ffmendonca/Projeto-VI/Modelos 3D/modulo_1x1_Kick-Tampa.stl

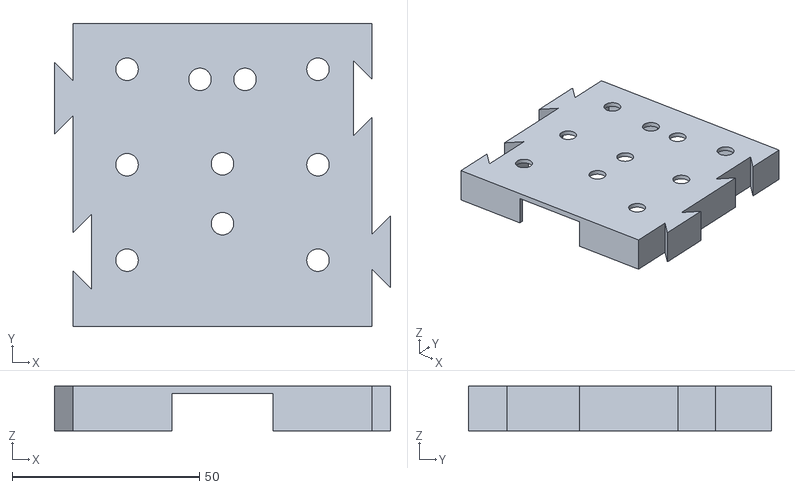
[picture p98: CAD file, 2025-10-30]
Modelos 3D/modulo_1x1_Kick-Tampa.stl
89.8 x 81.0 x 12.0
