ffmendonca/Projeto-VI/Modelos 3D/con_lateral_R.stl

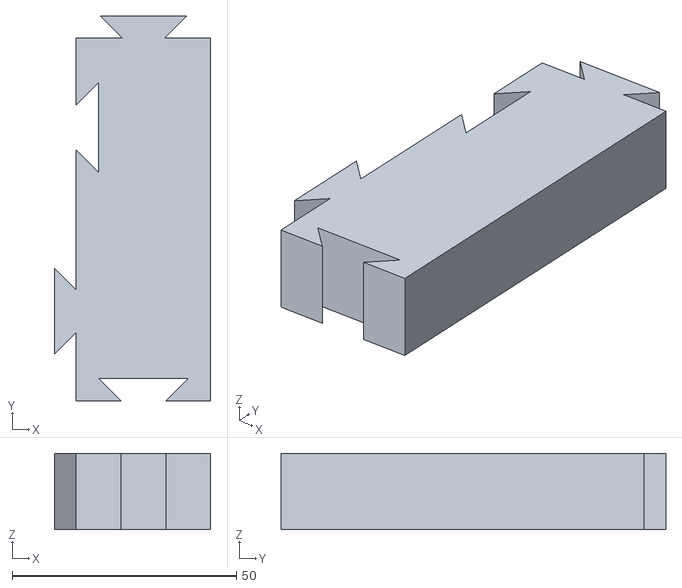
[picture p99: CAD file, 2025-10-30]
Modelos 3D/con_lateral_R.stl
34.9 x 85.9 x 17.0
