ffmendonca/Projeto-VI/Modelos 3D/modulo_1x1-Base.stl

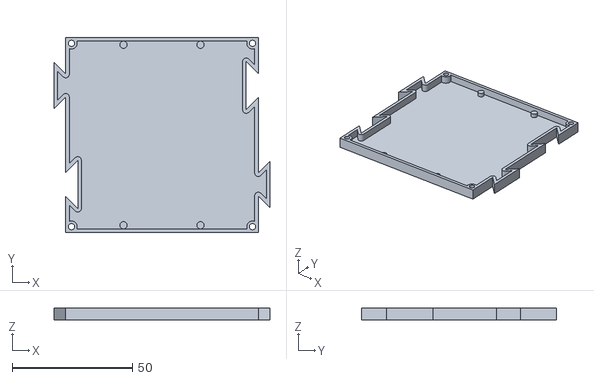
[picture p100: CAD file, 2025-10-30]
Modelos 3D/modulo_1x1-Base.stl
89.8 x 81.0 x 5.00
