ffmendonca/Projeto-VI/(list of files, cad)

Other CAD files:
Modelos 3D/modulo_1x1-Tampa.stl
Modelos 3D/con_lateral_L.stl
