ffmendonca/Projeto-VI/Esquemáticas/BOMBO.pdf

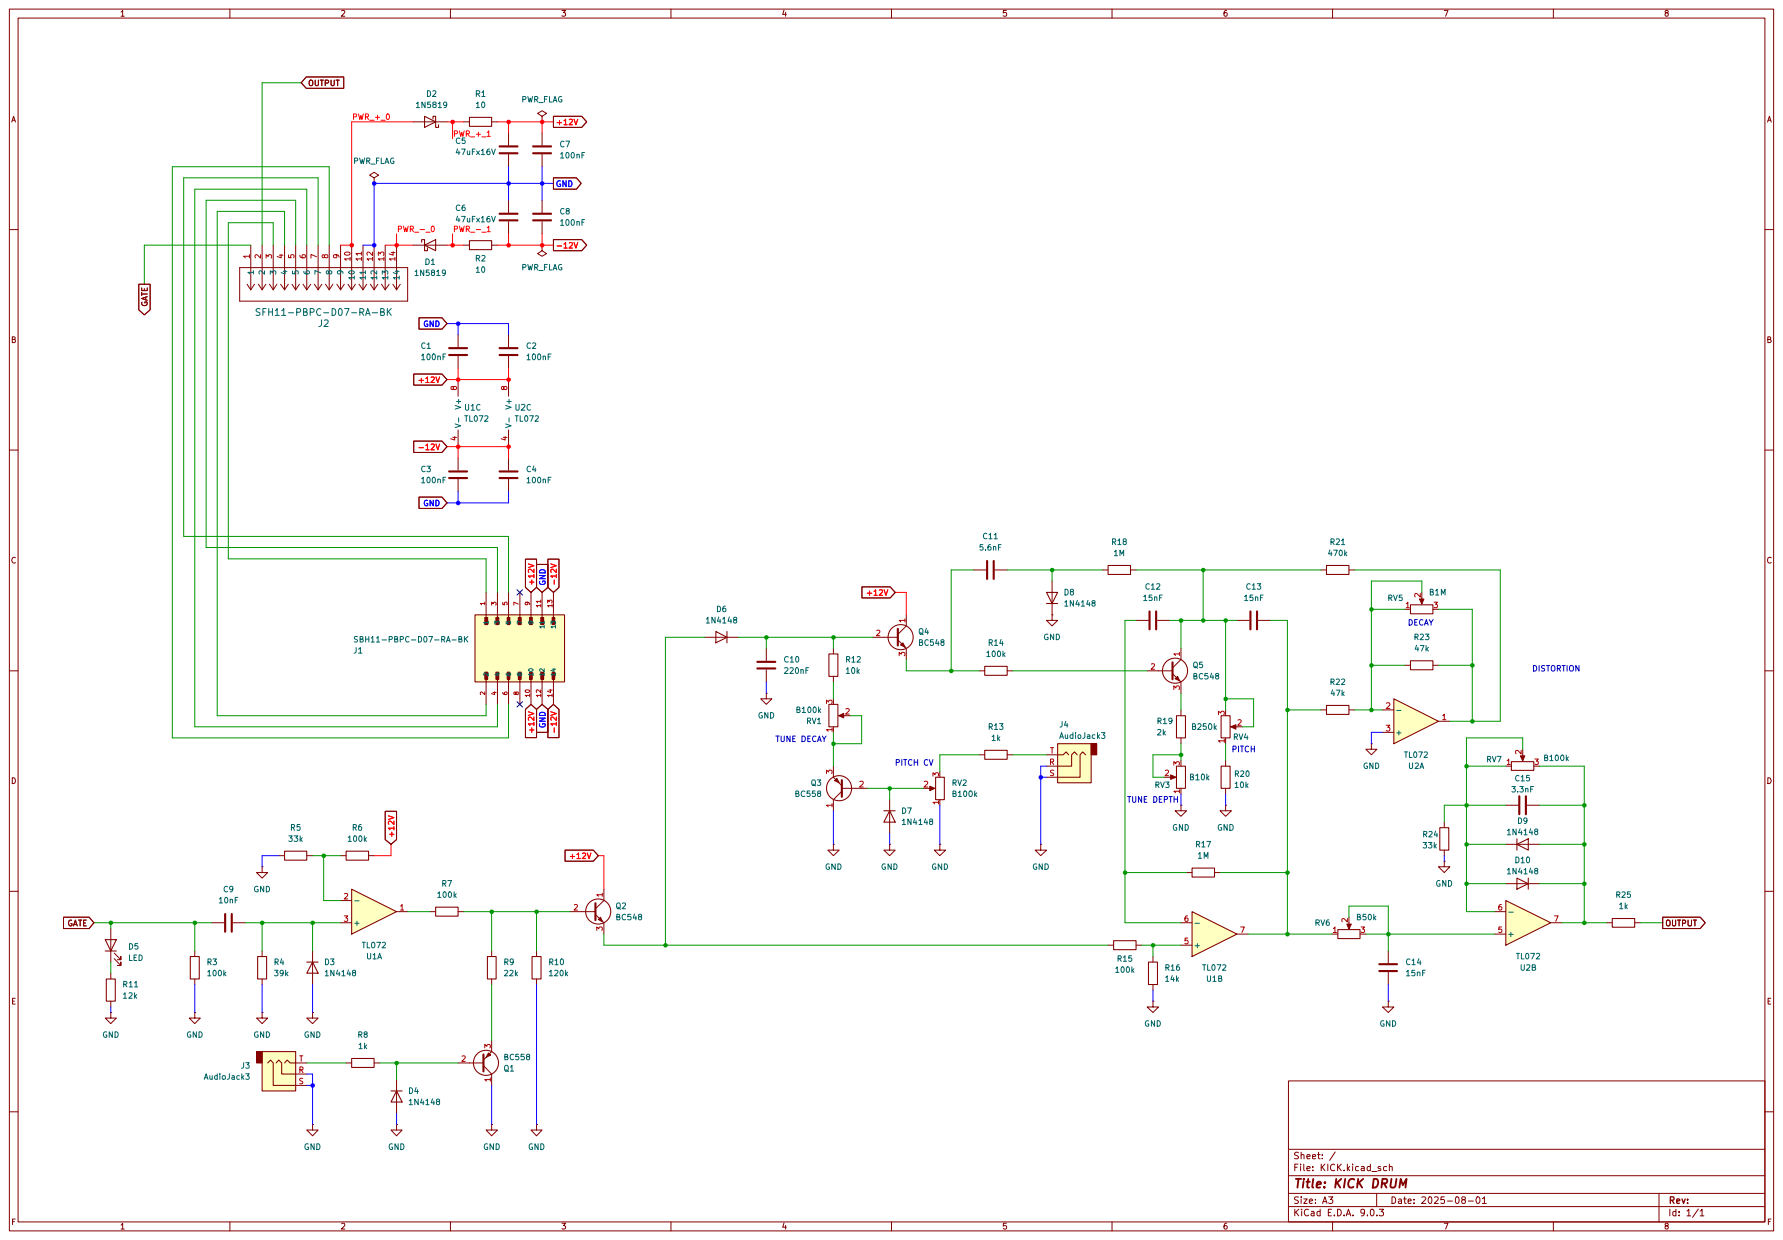
[picture p101: page 1]
