ffmendonca/Projeto-VI/Esquemáticas/INPUT ALIMENTAÇÃO.pdf

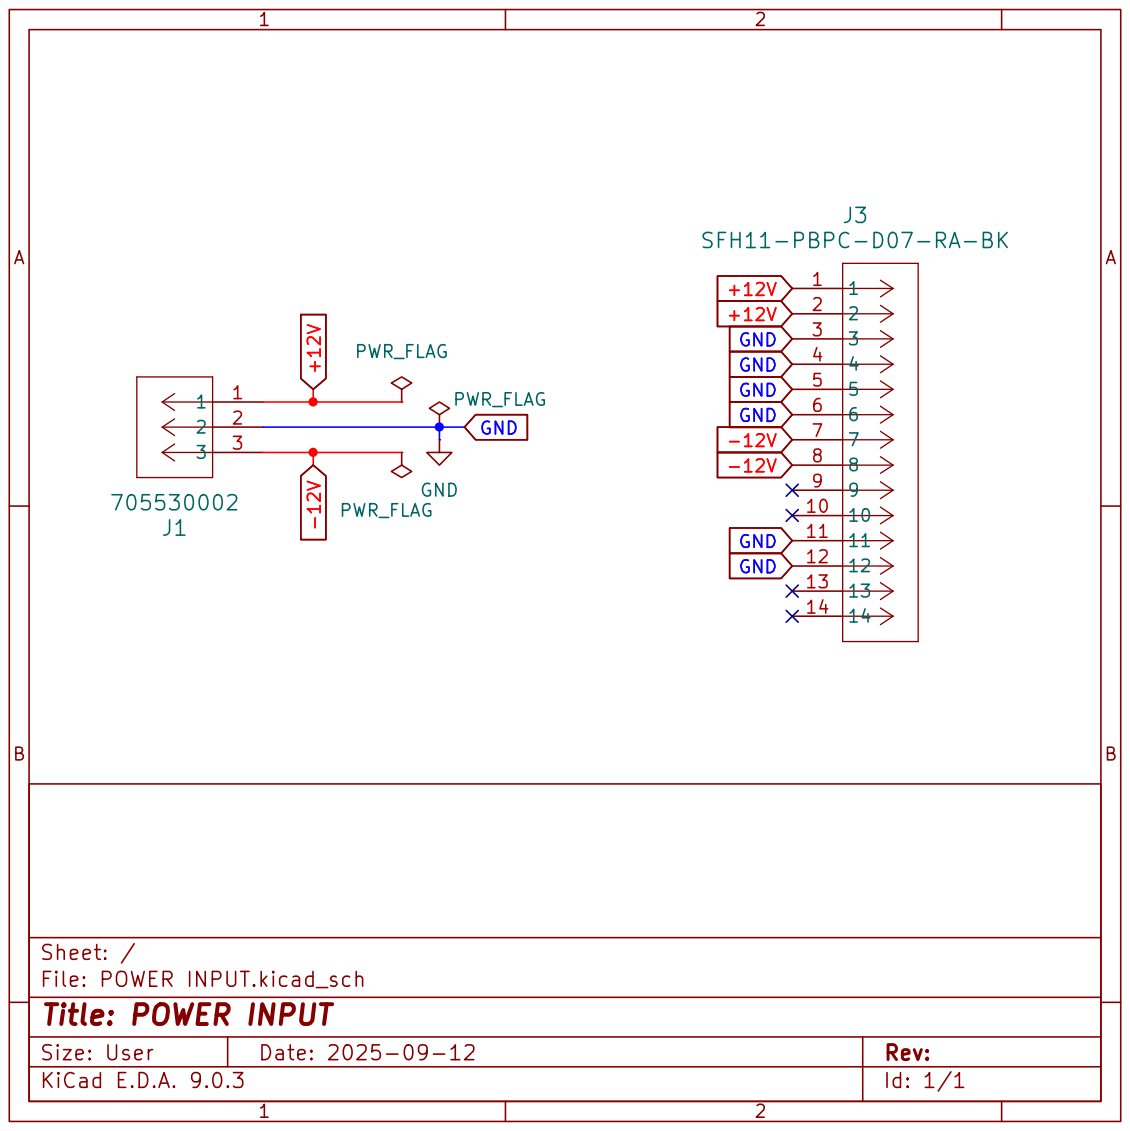
[picture p102: page 1]
