ffmendonca/Projeto-VI/Esquemáticas/IO.pdf

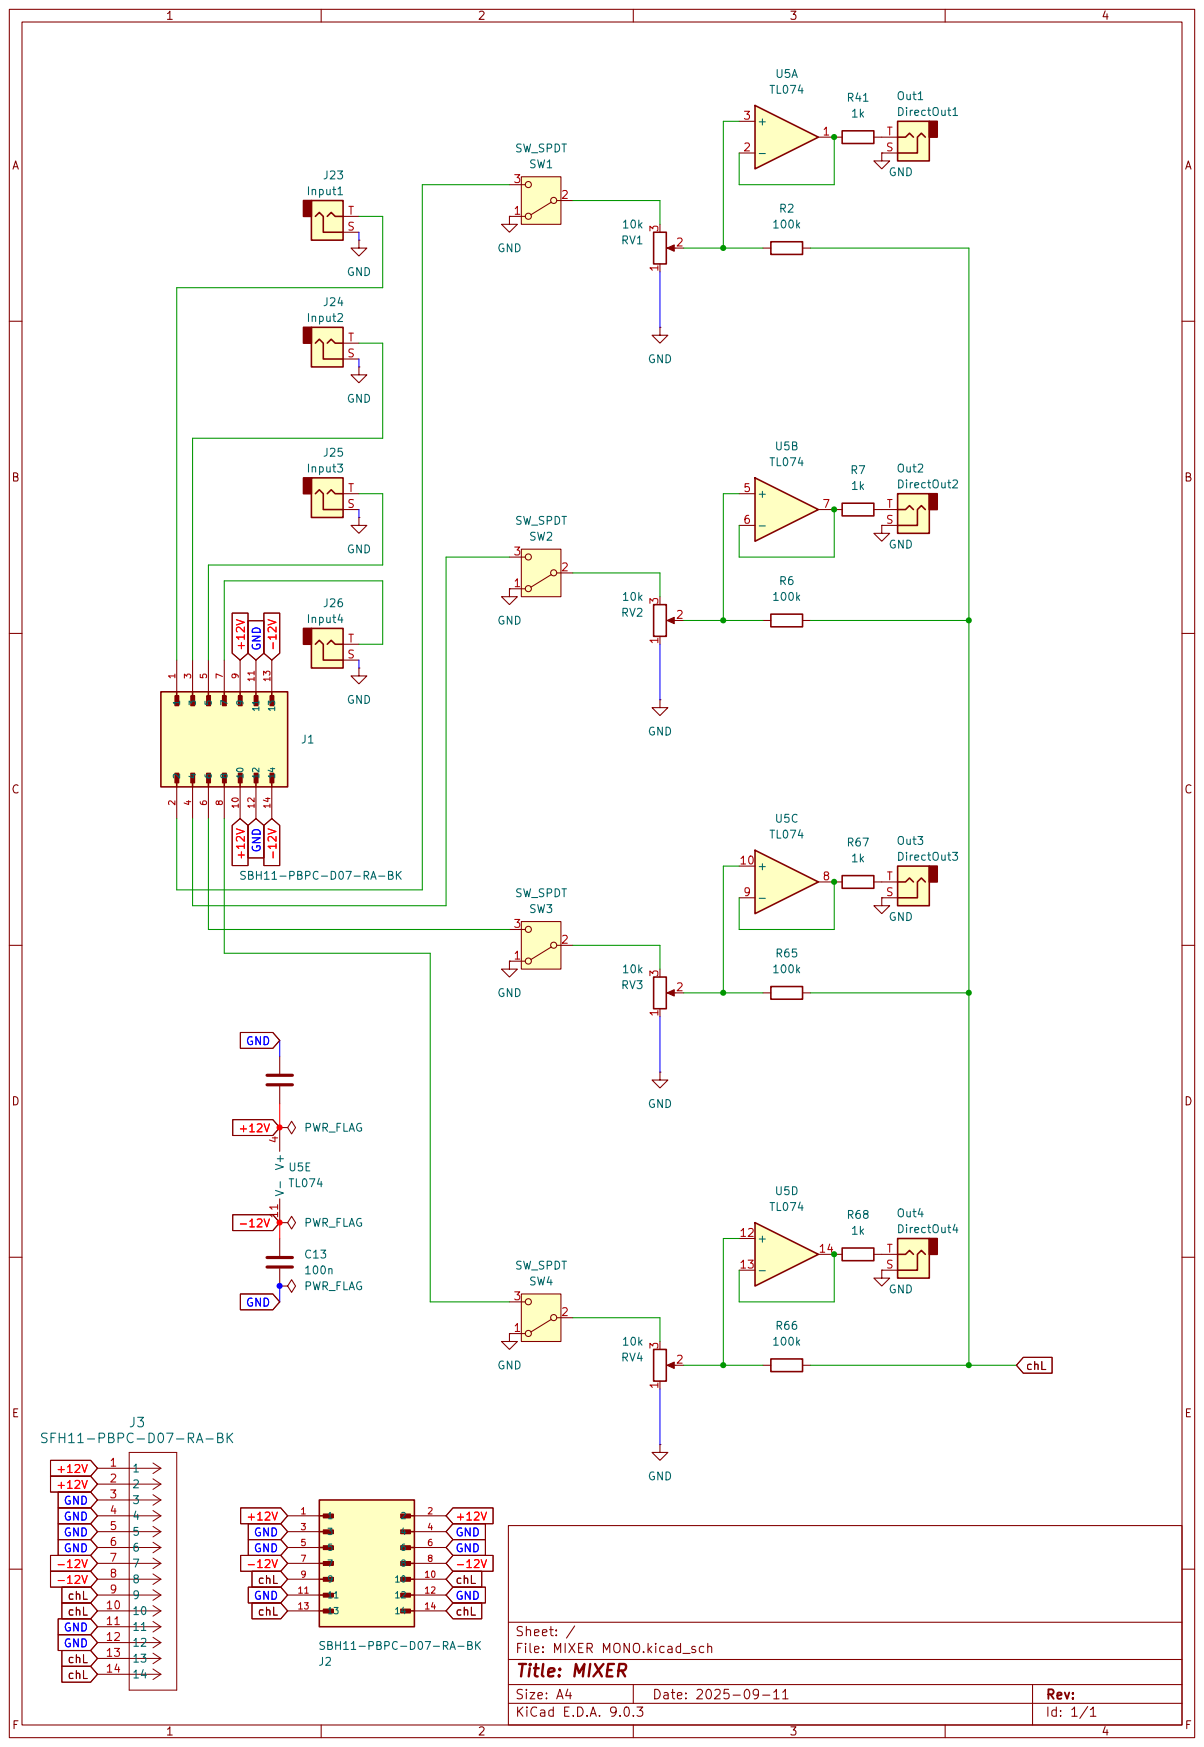
[picture p103: page 1]
