ffmendonca/Projeto-VI/Esquemáticas/OUTPUT PRINCIPAL.pdf

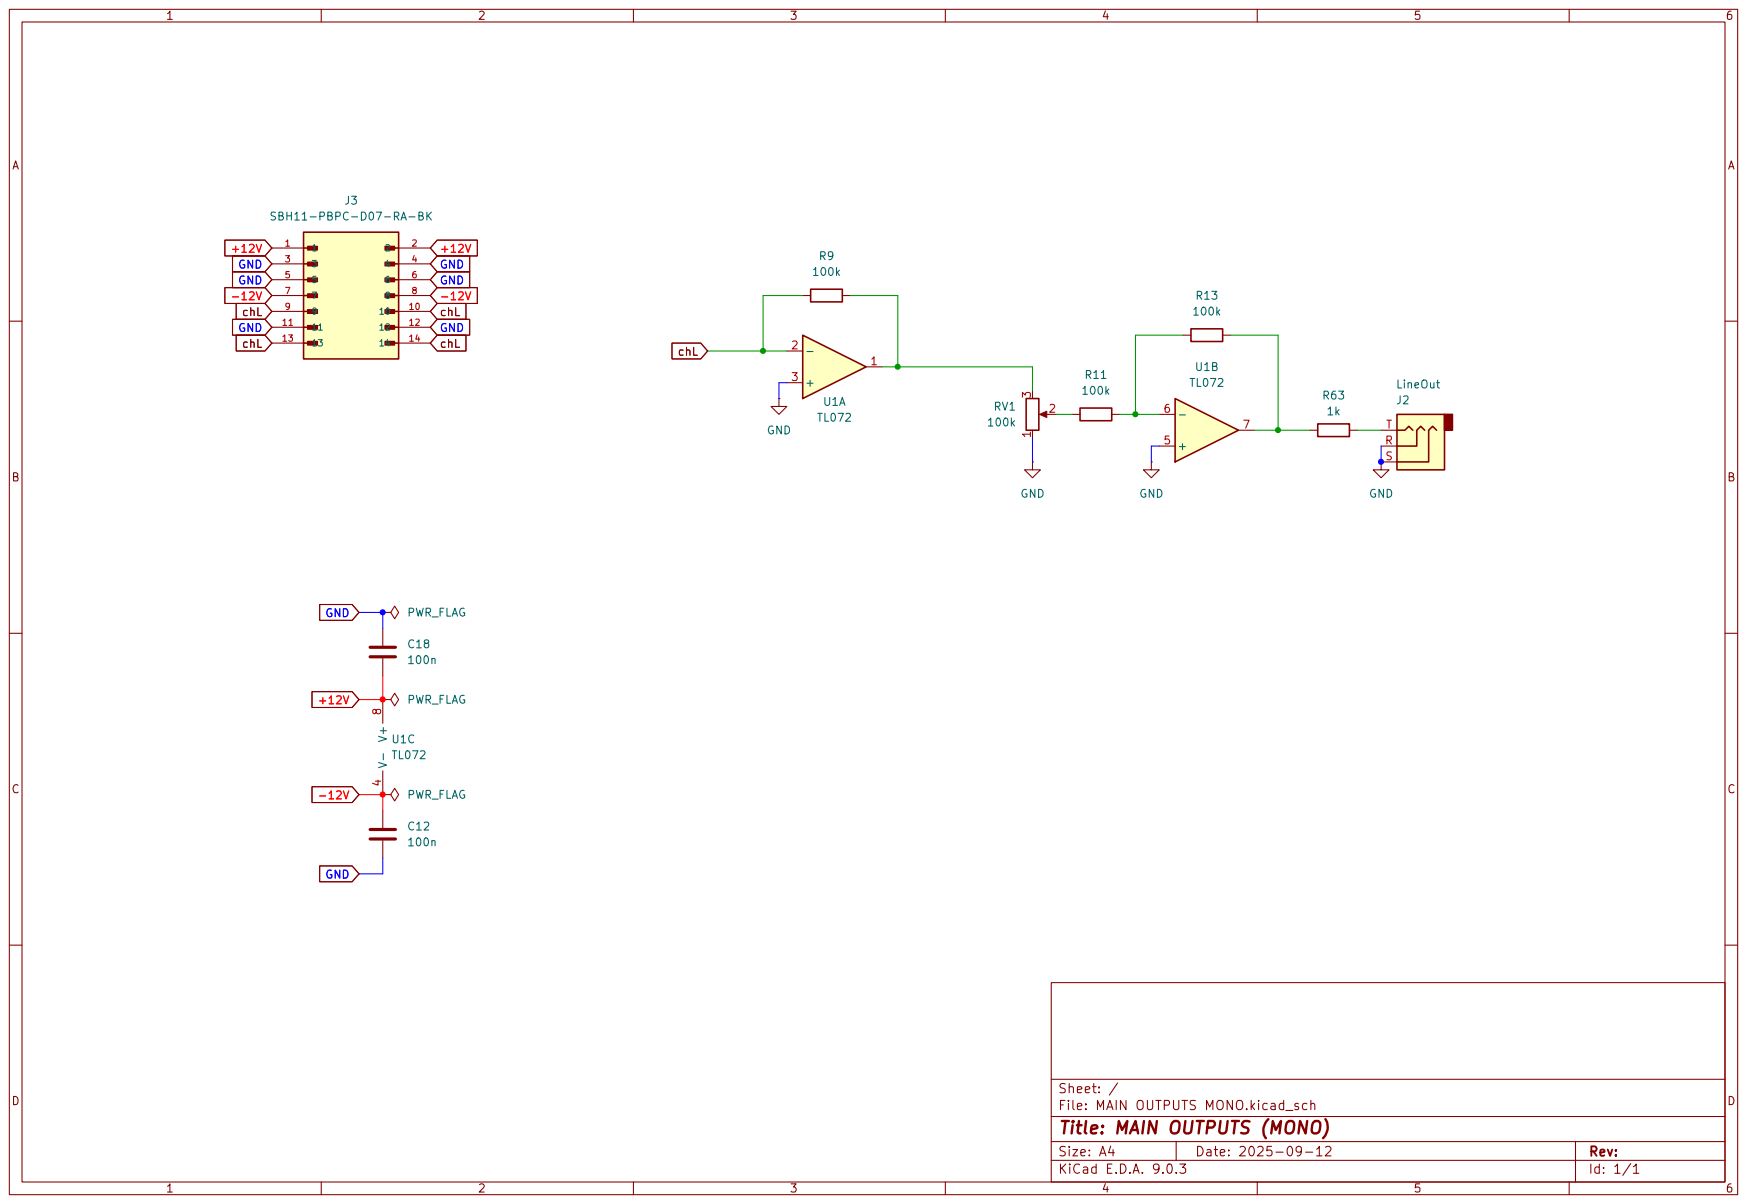
[picture p104: page 1]
