ffmendonca/Projeto-VI/Esquemáticas/PRATO.pdf

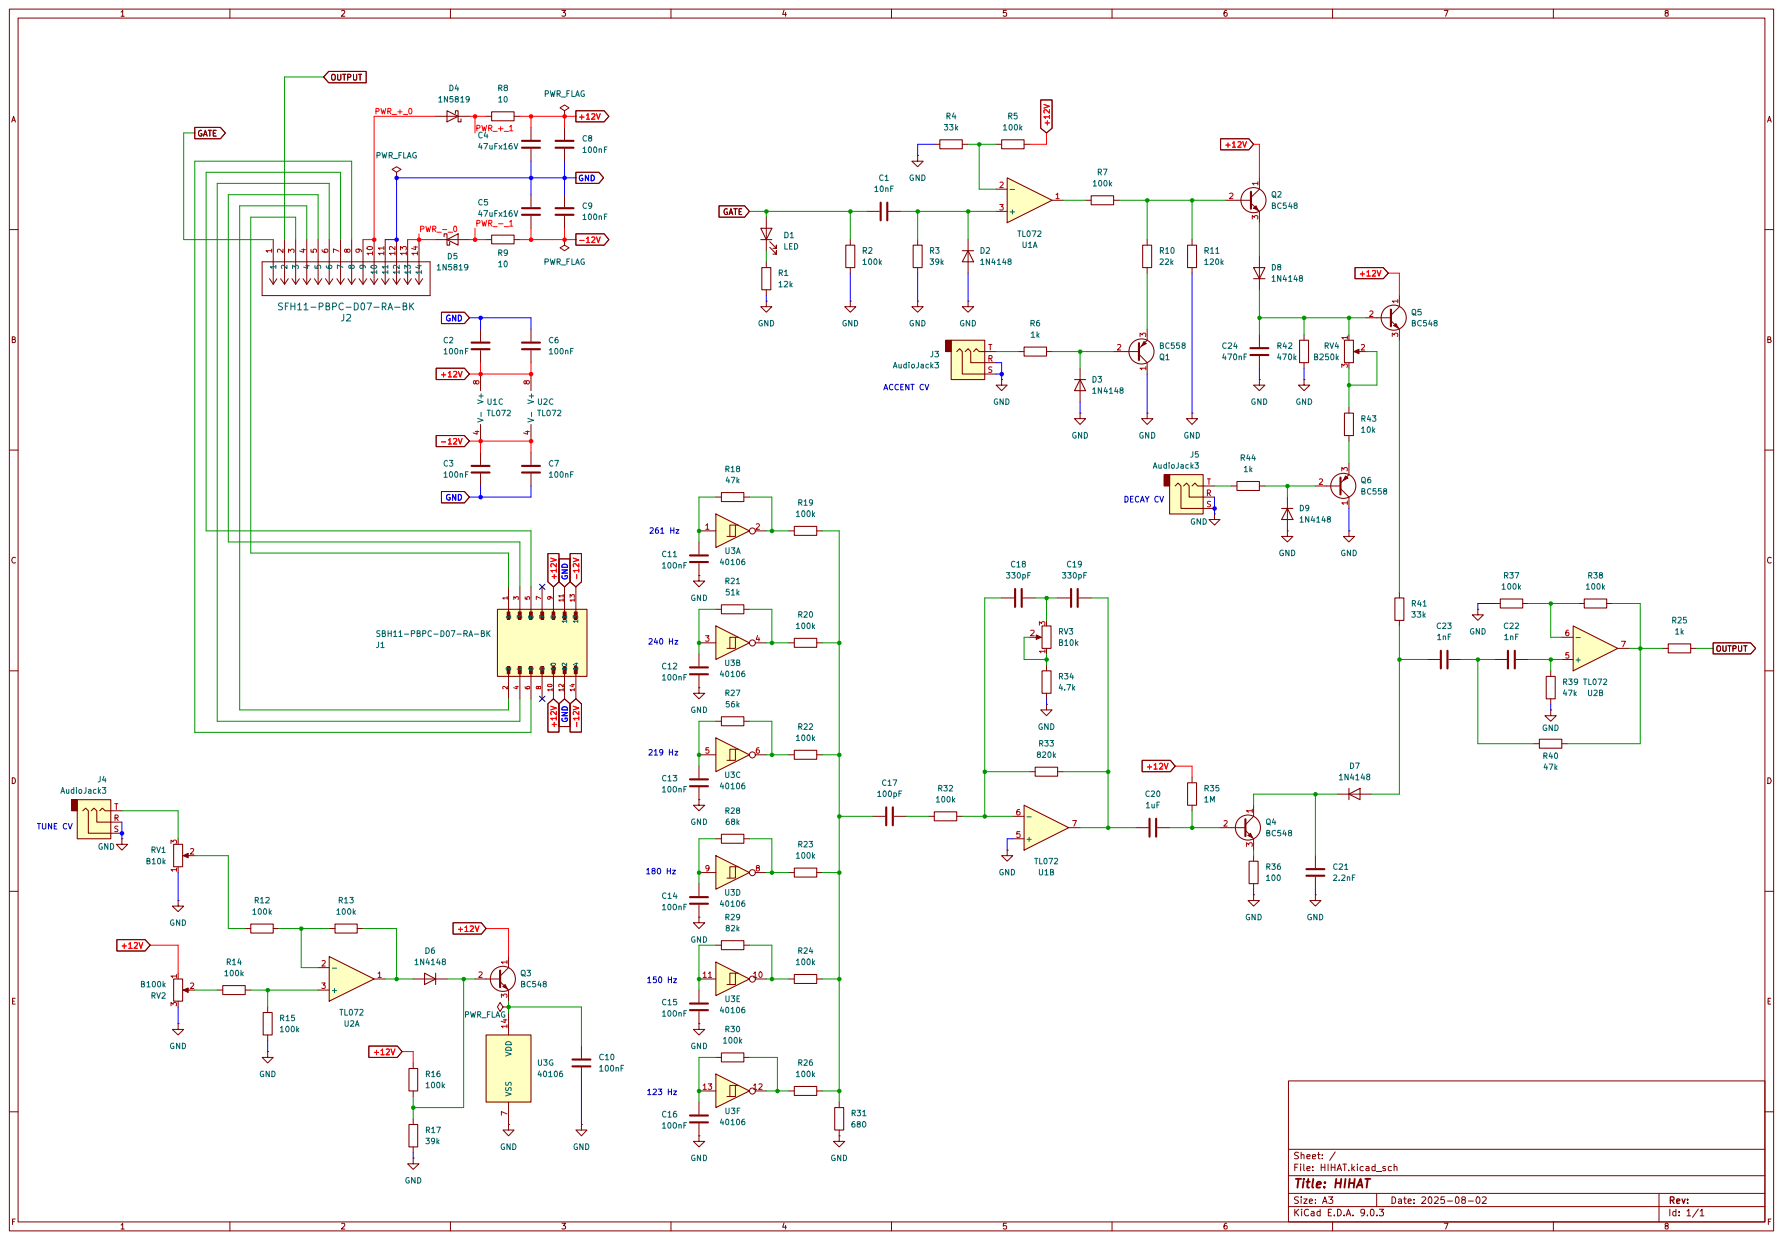
[picture p105: page 1]
