ffmendonca/Projeto-VI/Esquemáticas/PSU.pdf

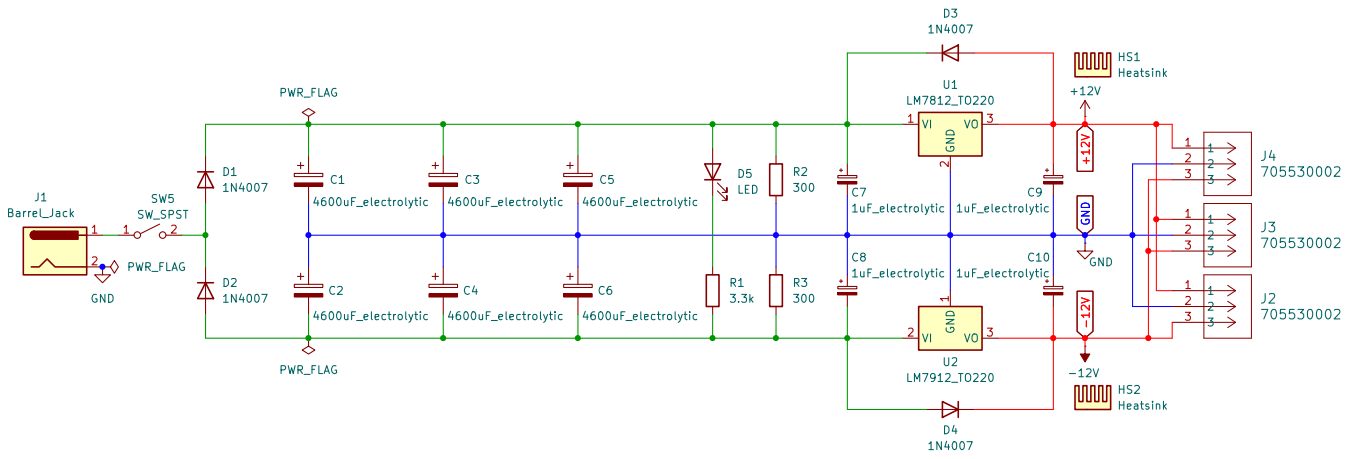
[picture p106: page 1]
