ffmendonca/Projeto-VI/Esquemáticas/TAROLA.pdf

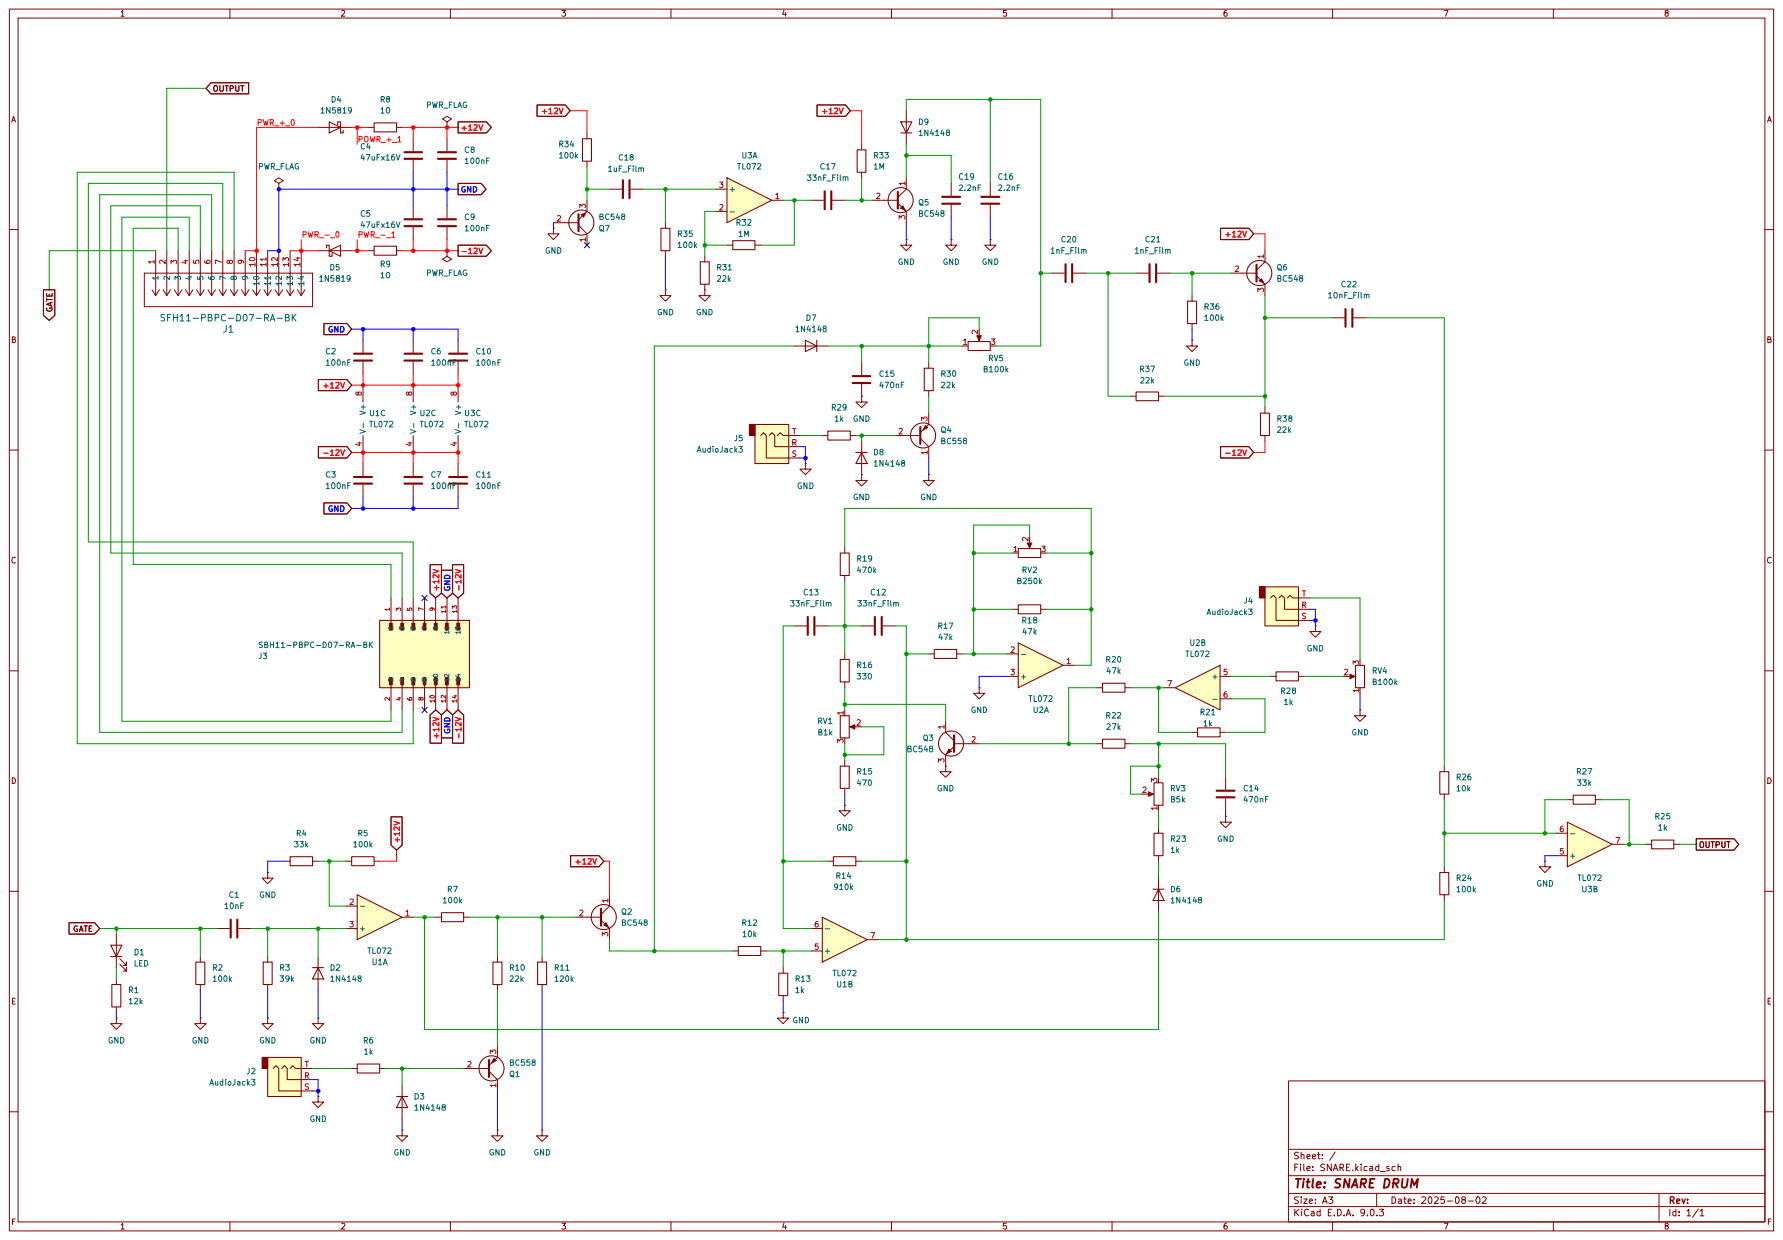
[picture p107: page 1]
