ffmendonca/Projeto-VI/Esquemáticas/VCO.pdf

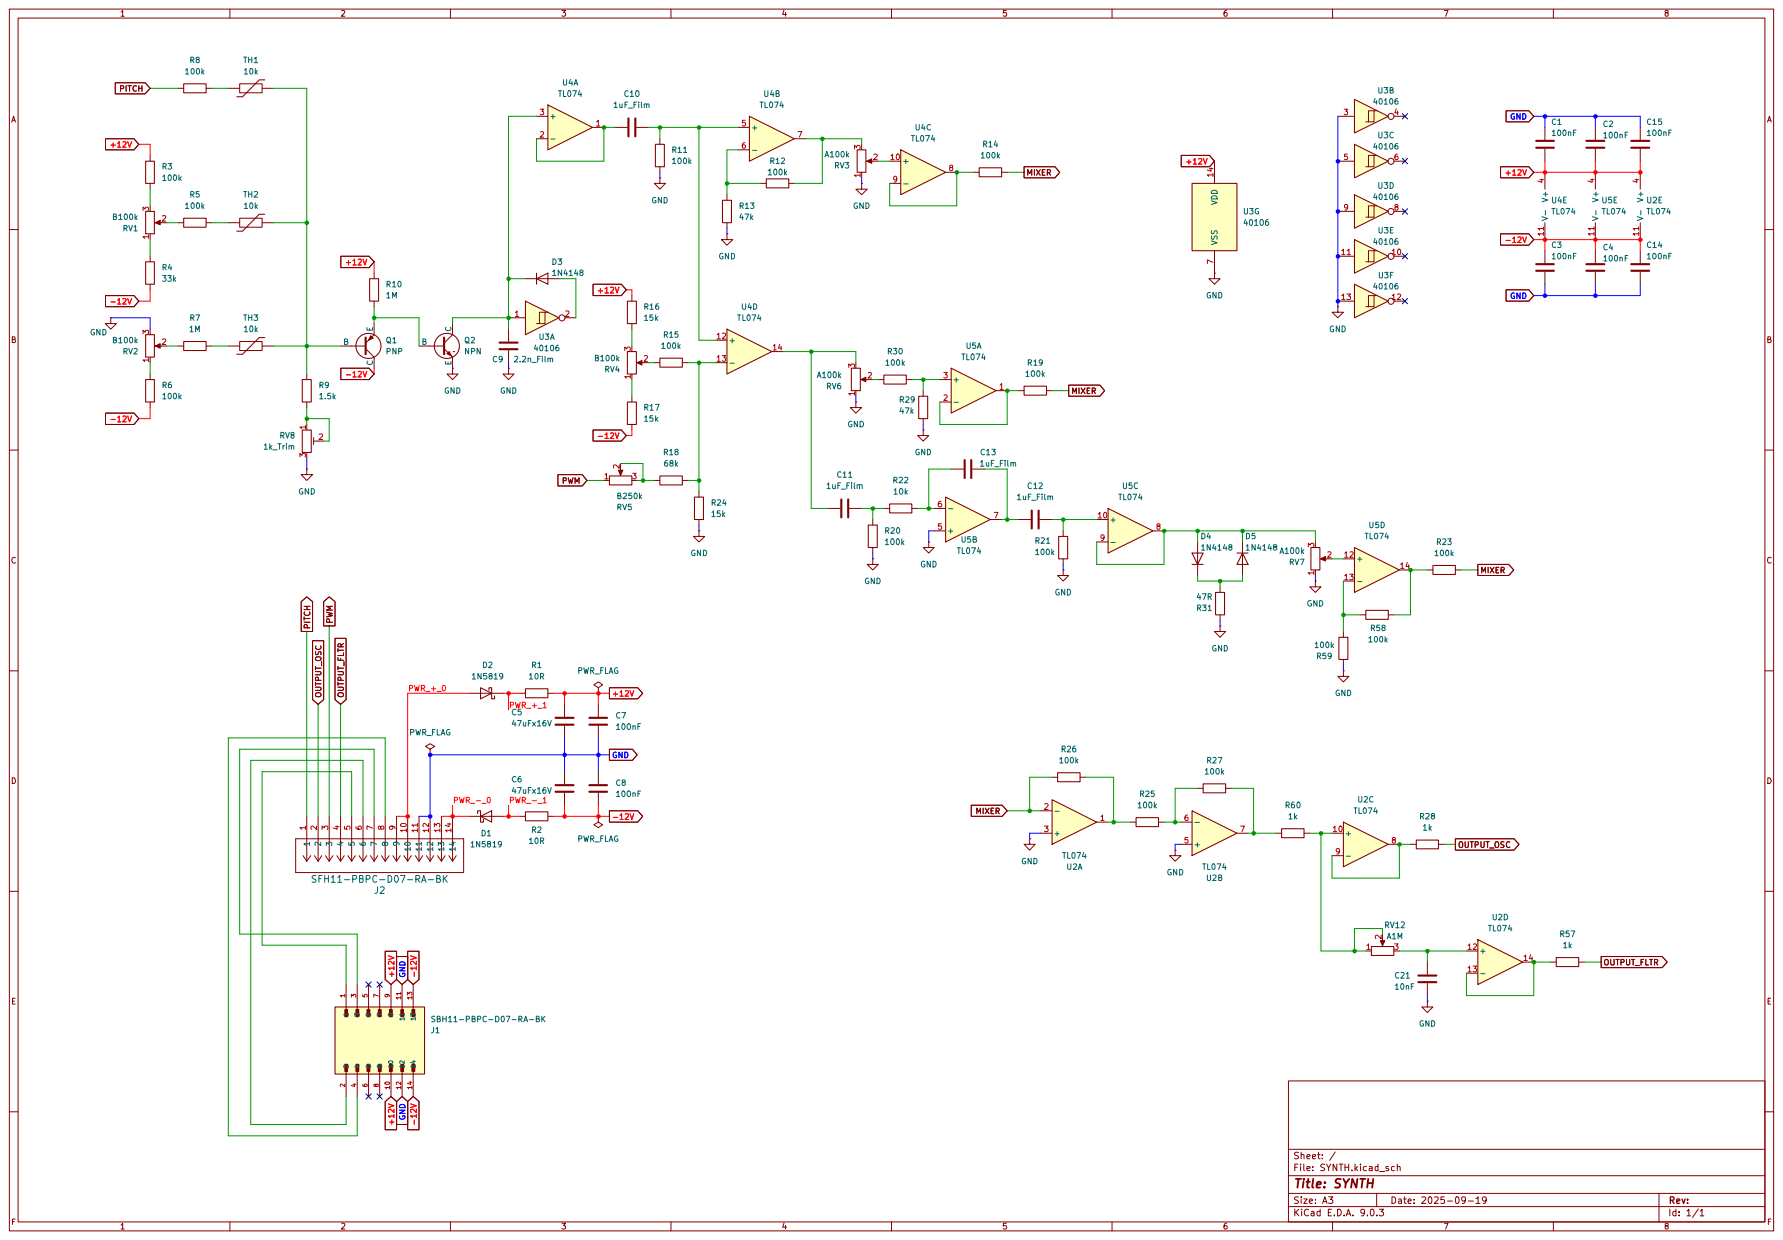
[picture p108: page 1]
