ffmendonca/Projeto-VI/(commit log)

2025-10-30 Esquemáticas e modelos 3D
    [con_lateral_L.stl, con_lateral_R.stl, modulo_1x1-Base.stl, modulo_1x1-Tampa.stl, modulo_1x1_Kick-Tampa.stl]
2025-10-30 Ficheiros para fabrico
    [bom.csv, designators.csv, positions.csv]
